Tsjakka/WeatherStation/Hardware/WeatherStation-top.png

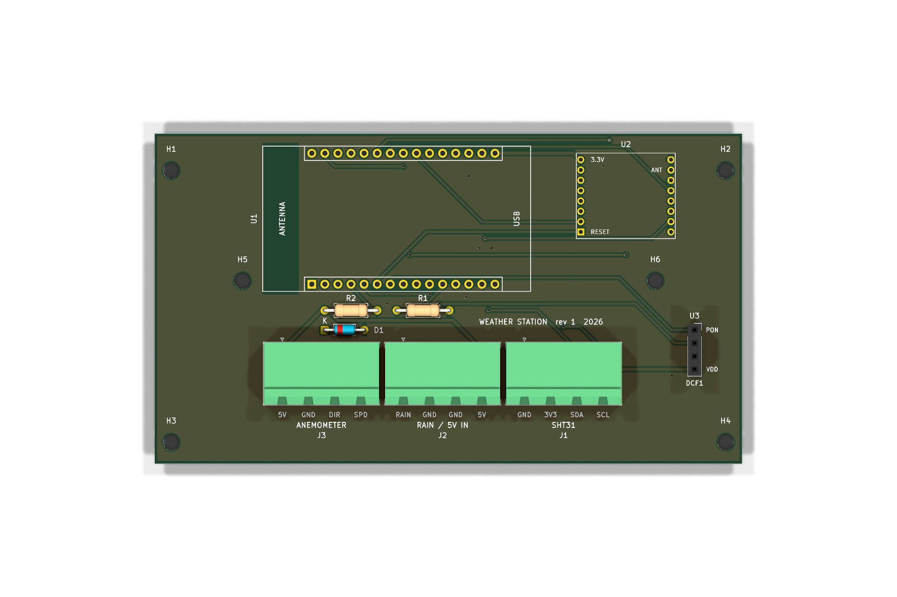
Hardware/WeatherStation-top.png
