Tsjakka/WeatherStation/Photos/Arduino settings.gif

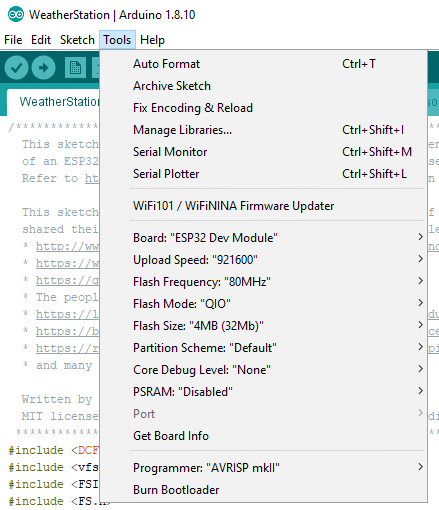
Photos/Arduino settings.gif
