Tsjakka/WeatherStation/Photos/IMG_2616.JPG

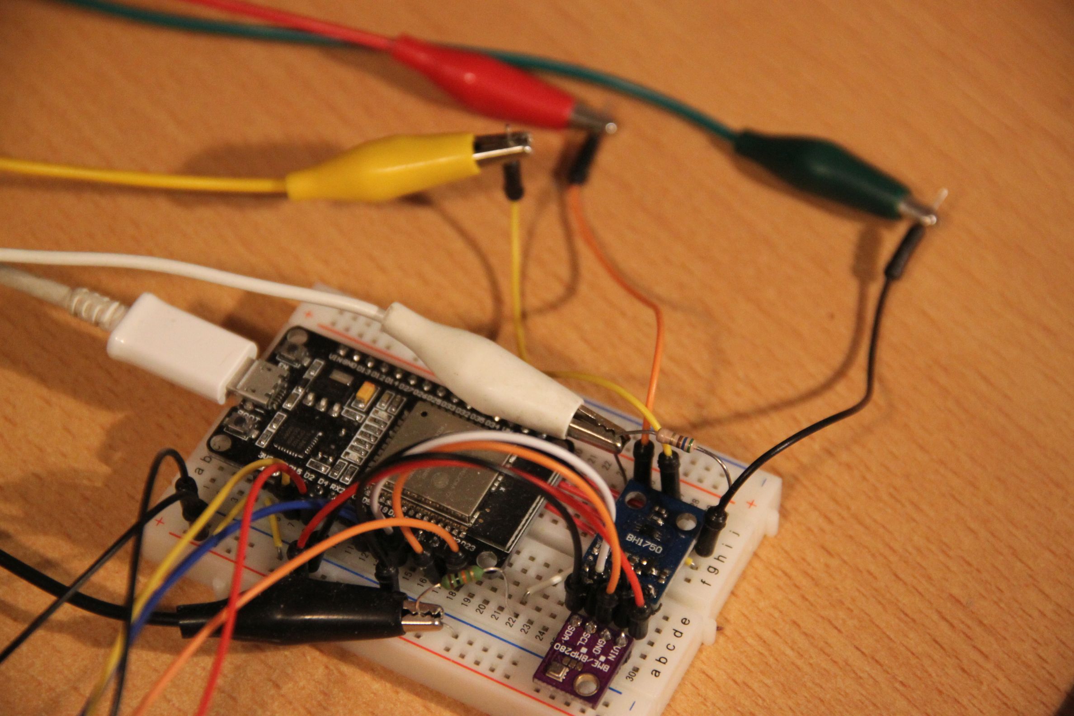
Photos/IMG_2616.JPG
