Tsjakka/WeatherStation/Photos/IMG_2619.JPG

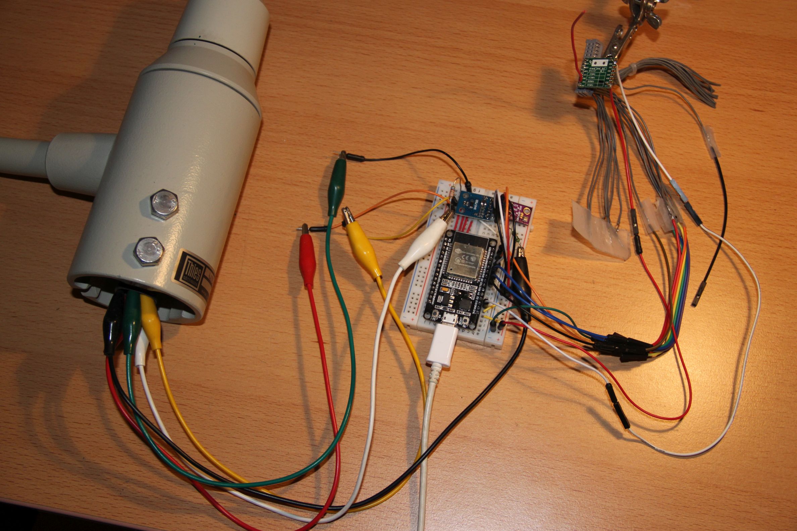
Photos/IMG_2619.JPG
