Tsjakka/WeatherStation/Photos/IMG_2621.JPG

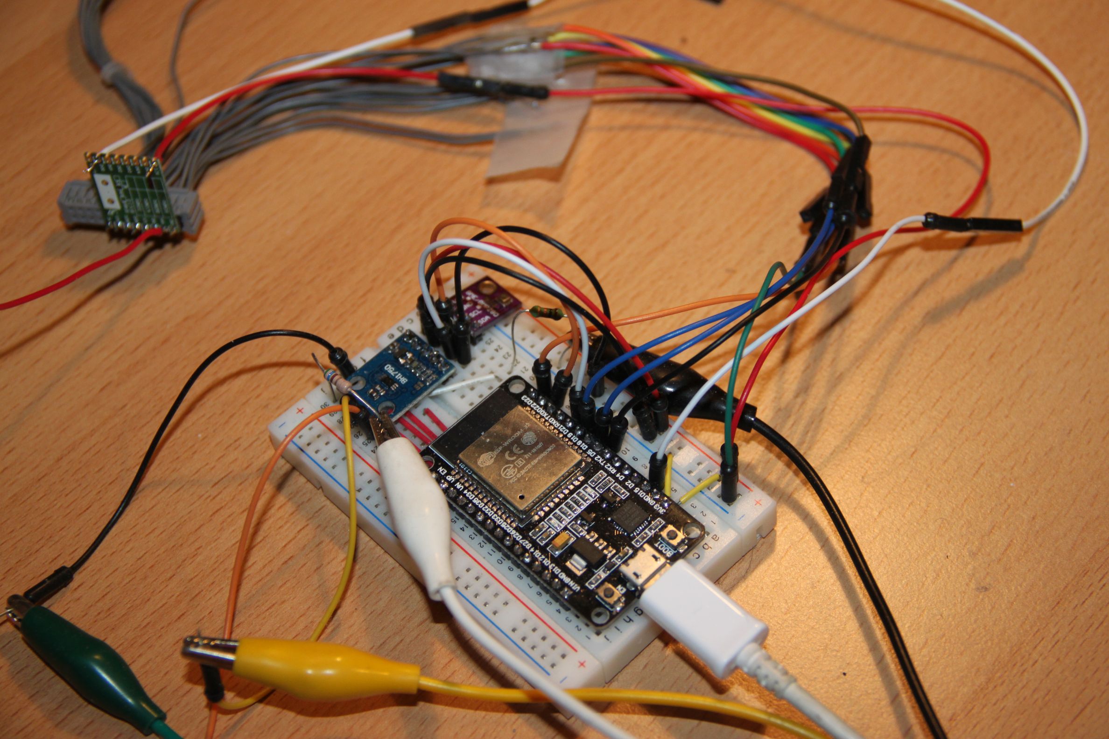
Photos/IMG_2621.JPG
