Tsjakka/WeatherStation/Photos/IMG_2628.JPG

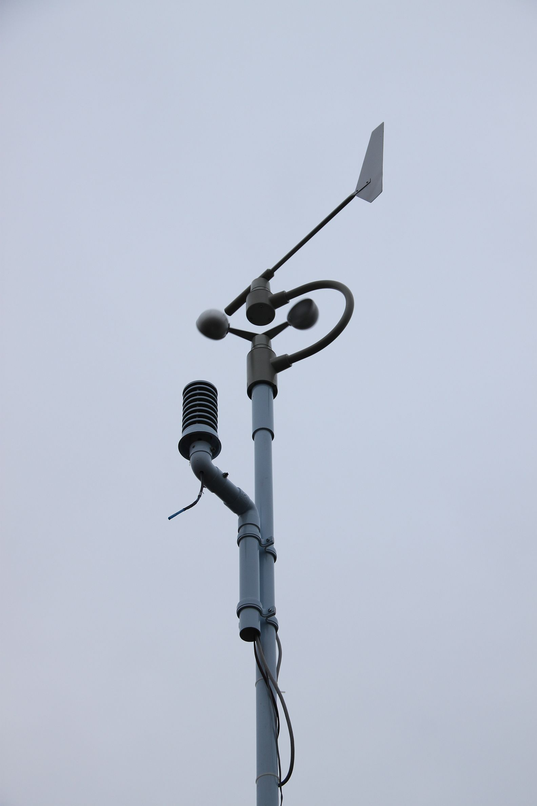
Photos/IMG_2628.JPG
