Tsjakka/WeatherStation/Photos/IMG_20181224_183357316.jpg

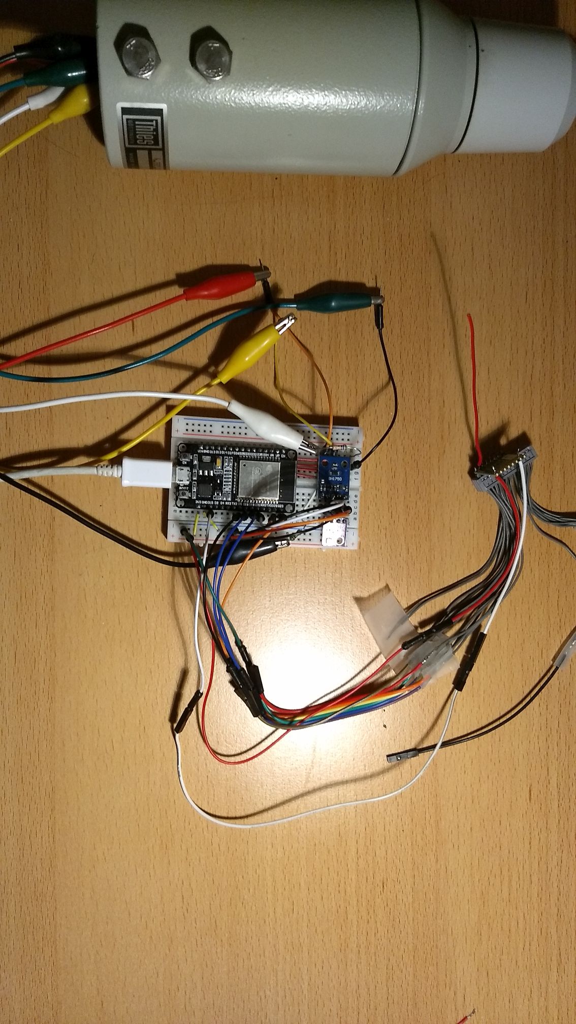
Photos/IMG_20181224_183357316.jpg
