Tsjakka/WeatherStation/Photos/IMG_20181224_183402917.jpg

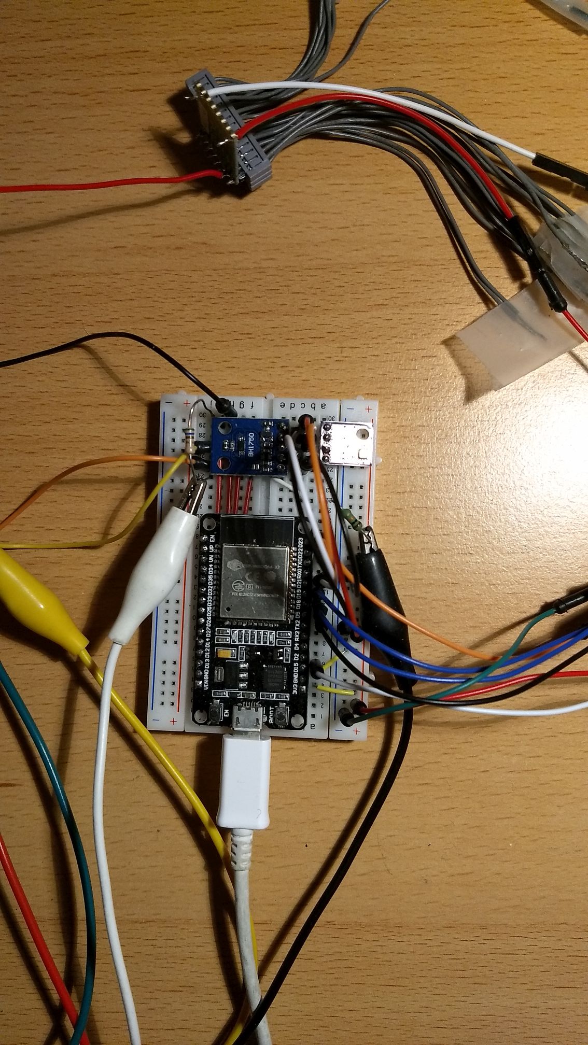
Photos/IMG_20181224_183402917.jpg
