Tsjakka/WeatherStation/Photos/IMG_20181224_183424407.jpg

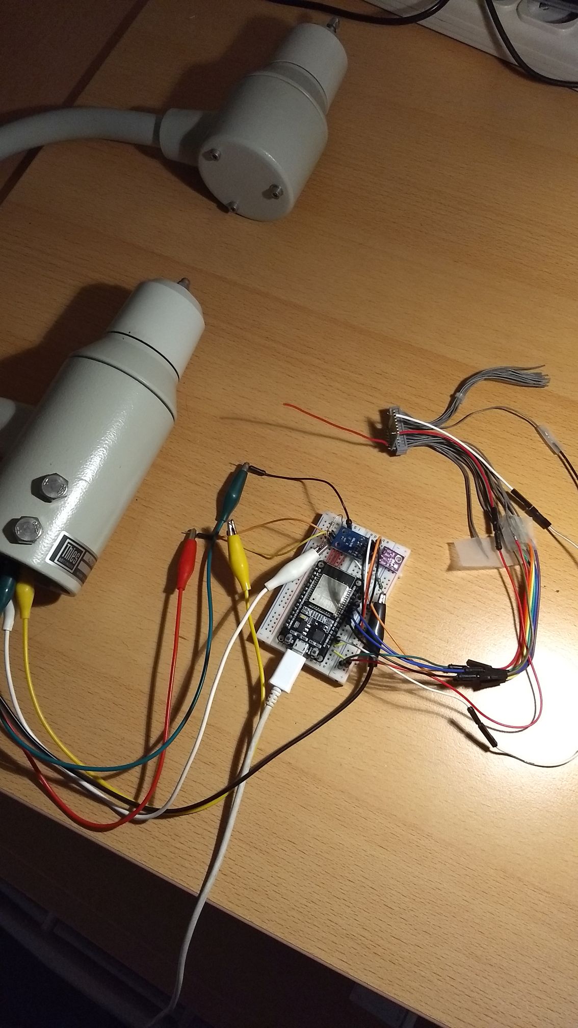
Photos/IMG_20181224_183424407.jpg
