Tsjakka/WeatherStation/Photos/IMG_20181224_183455740.jpg

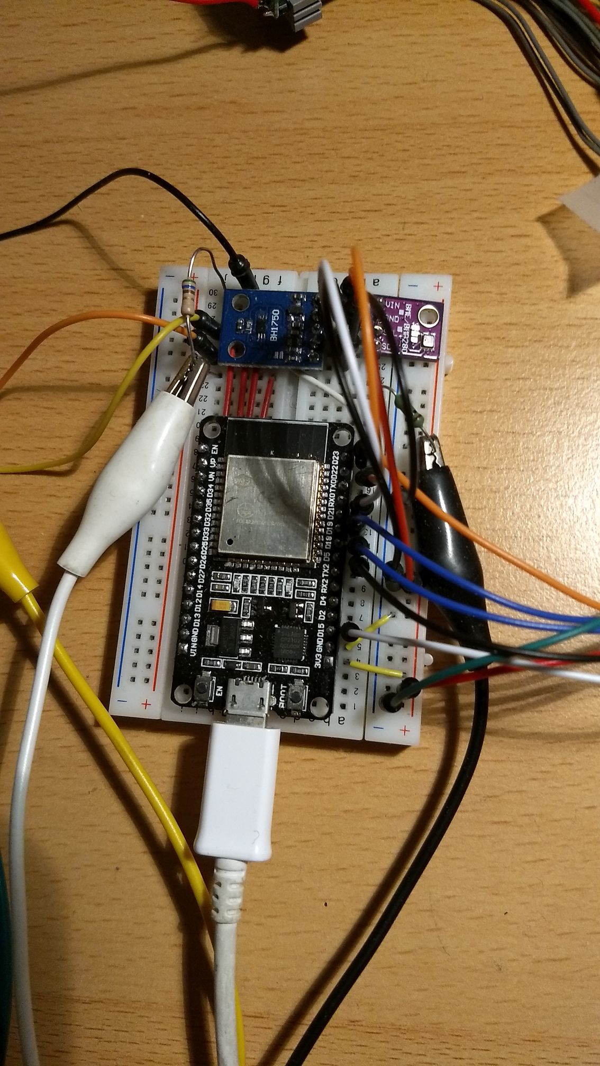
Photos/IMG_20181224_183455740.jpg
