Tsjakka/WeatherStation/Photos/IMG_20190520_220154558.jpg

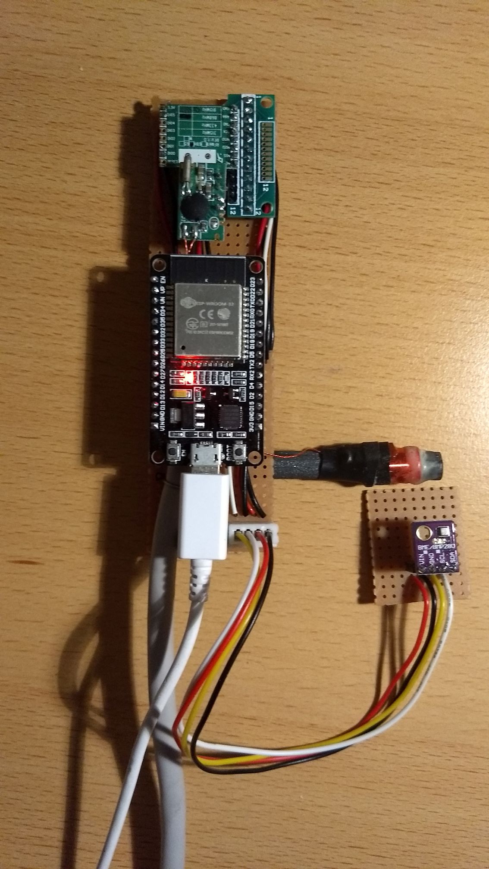
Photos/IMG_20190520_220154558.jpg
