Tsjakka/WeatherStation/Photos/IMG_20190521_210232744.jpg

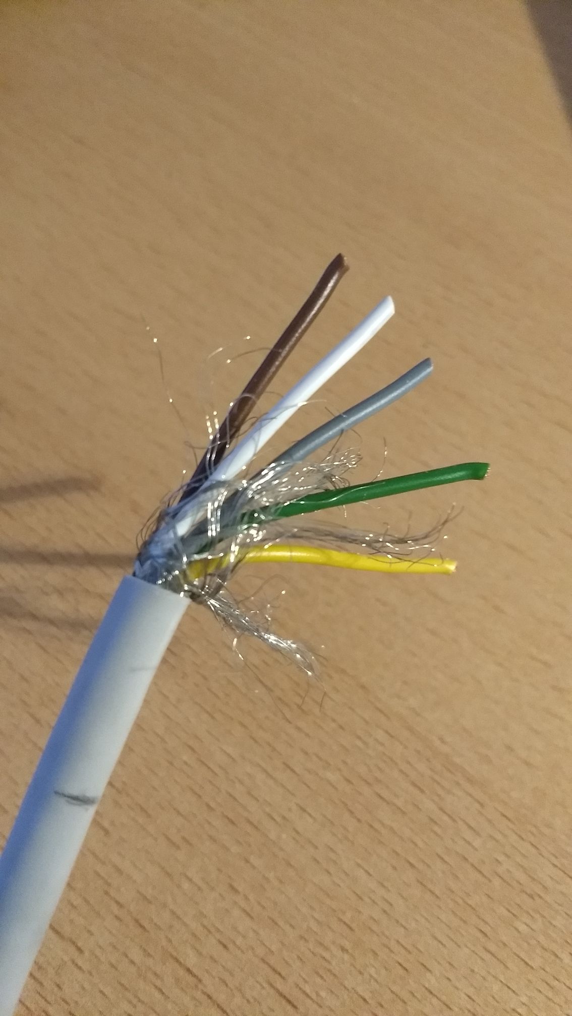
Photos/IMG_20190521_210232744.jpg
