Tsjakka/WeatherStation/Photos/IMG_20190720_095702261.jpg

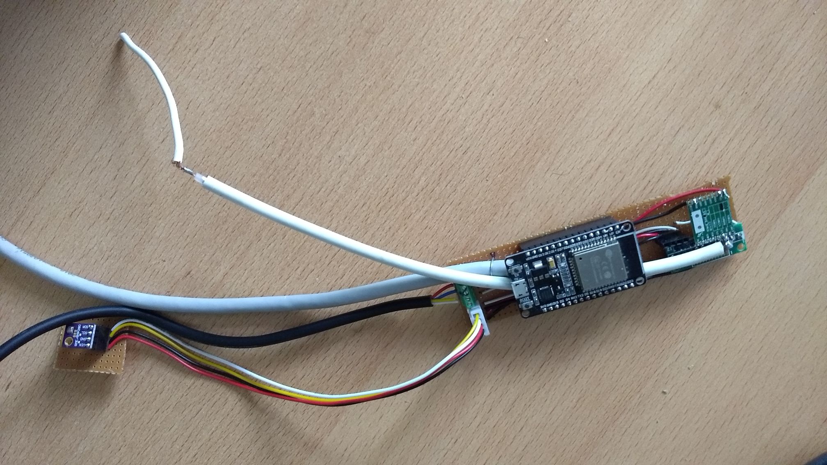
Photos/IMG_20190720_095702261.jpg
