Tsjakka/WeatherStation/Photos/IMG_20190720_095718628.jpg

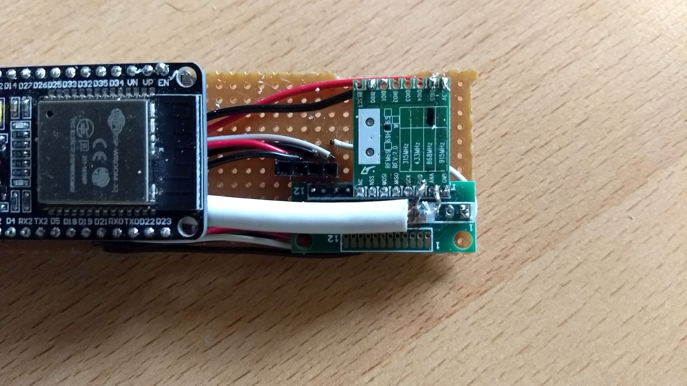
Photos/IMG_20190720_095718628.jpg
