Tsjakka/WeatherStation/Photos/IMG_20190803_145220831.jpg

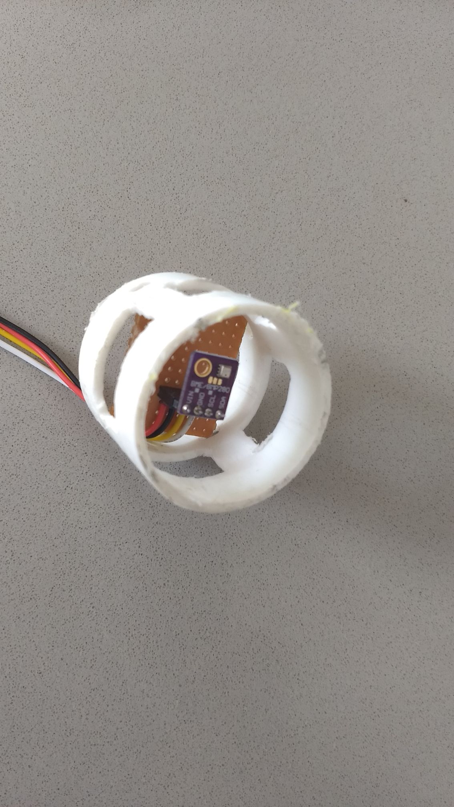
Photos/IMG_20190803_145220831.jpg
