Tsjakka/WeatherStation/Photos/IMG_20190803_145339822.jpg

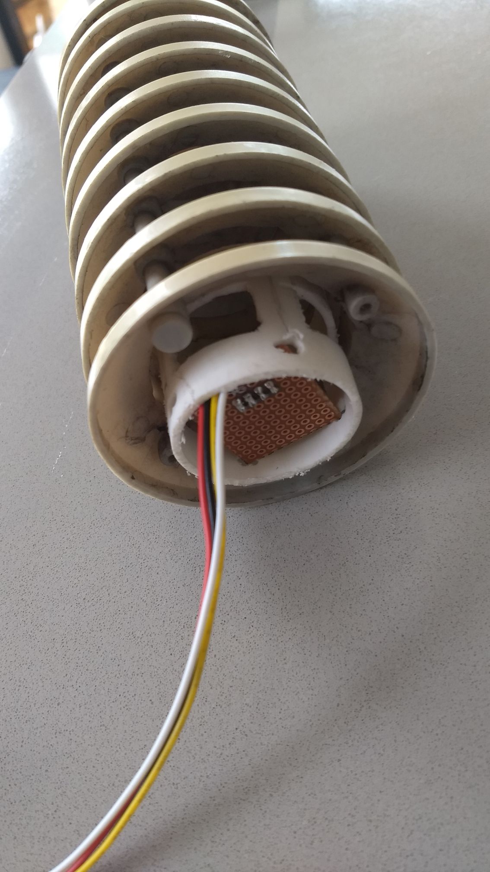
Photos/IMG_20190803_145339822.jpg
