Tsjakka/WeatherStation/Photos/IMG_20190807_215347973.jpg

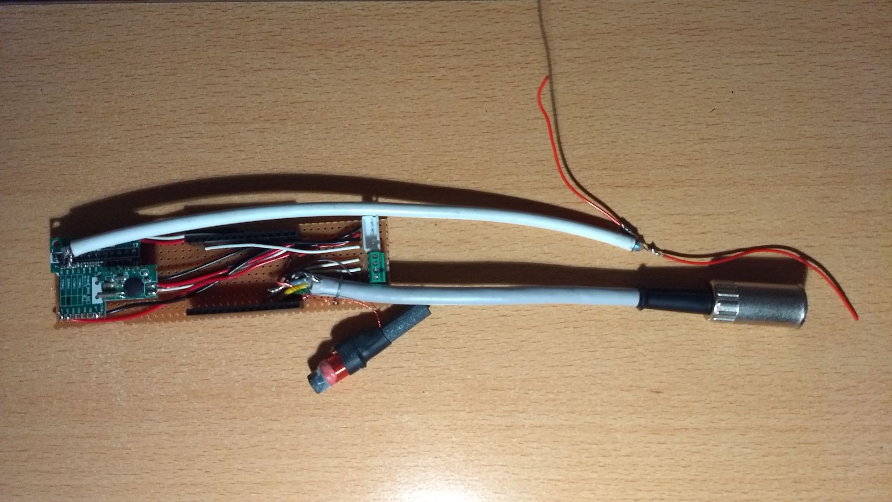
Photos/IMG_20190807_215347973.jpg
