Tsjakka/WeatherStation/Photos/IMG_20190807_215413689.jpg

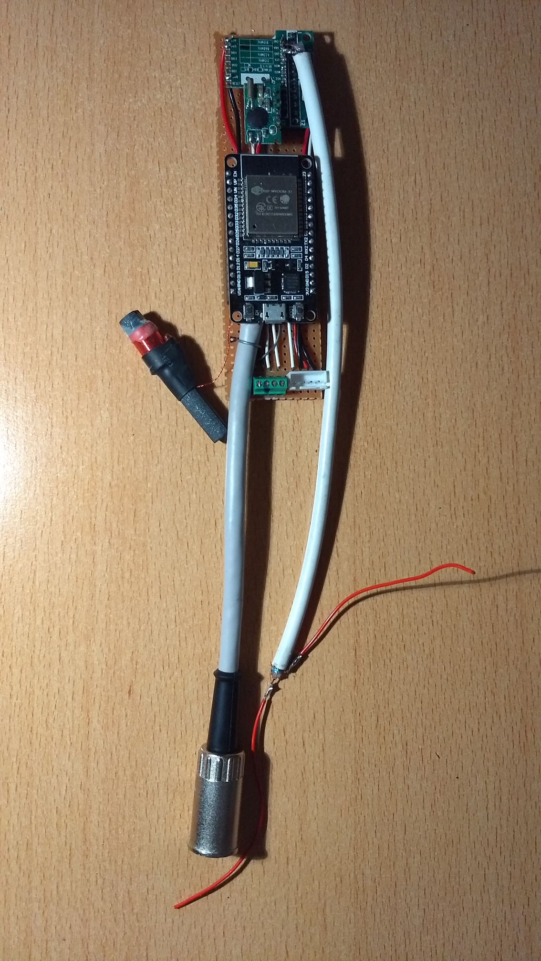
Photos/IMG_20190807_215413689.jpg
