Tsjakka/WeatherStation/Photos/IMG_20190807_215417791_small.jpg

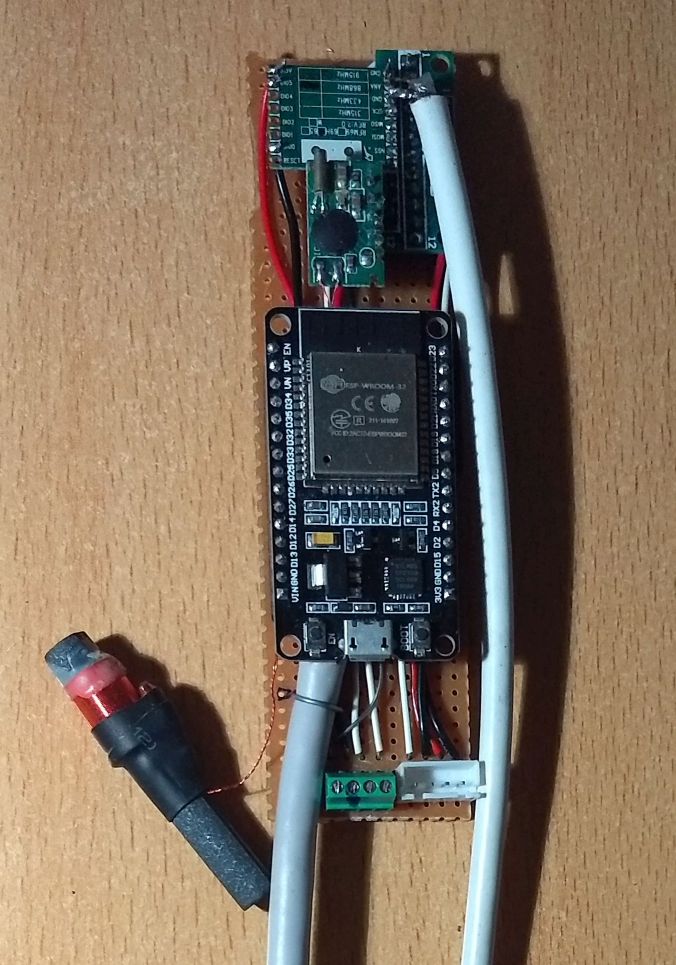
Photos/IMG_20190807_215417791_small.jpg
