Tsjakka/WeatherStation/Photos/IMG_20190813_203214440_HDR.jpg

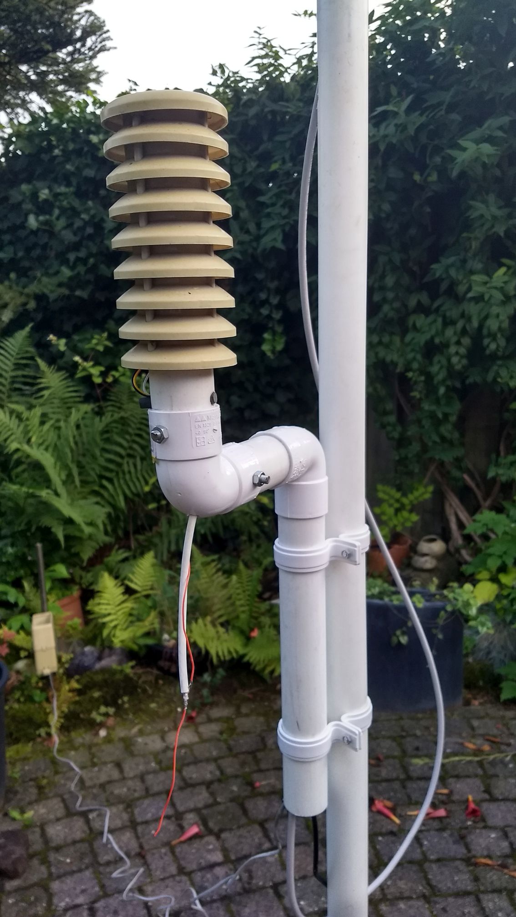
Photos/IMG_20190813_203214440_HDR.jpg
