Tsjakka/WeatherStation/Photos/PB140029.JPG

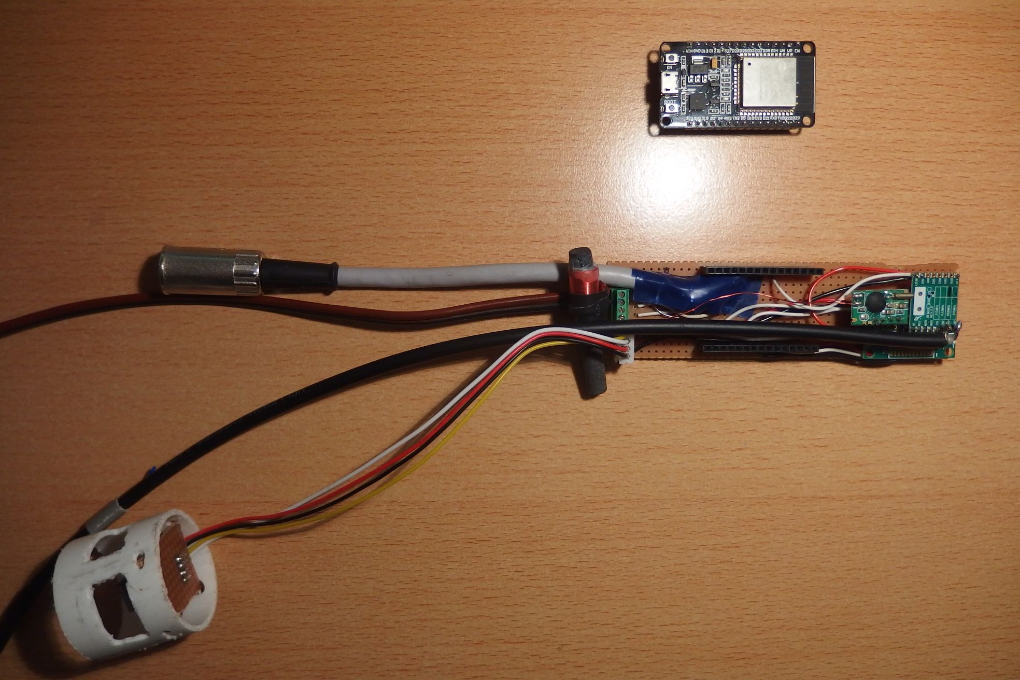
Photos/PB140029.JPG
