Tsjakka/WeatherStation/Photos/PB140033.JPG

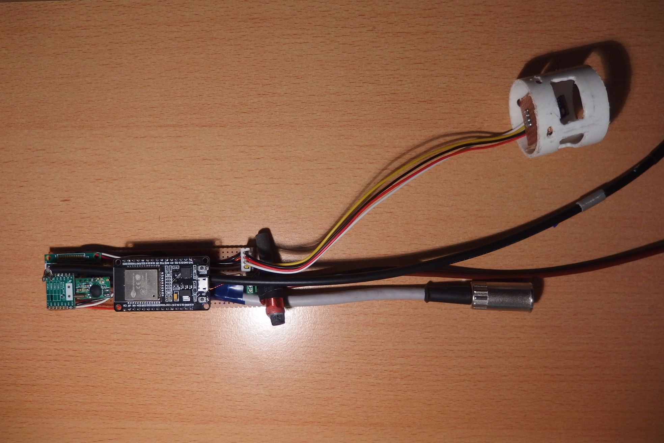
Photos/PB140033.JPG
