Tsjakka/WeatherStation/Photos/PB140034.JPG

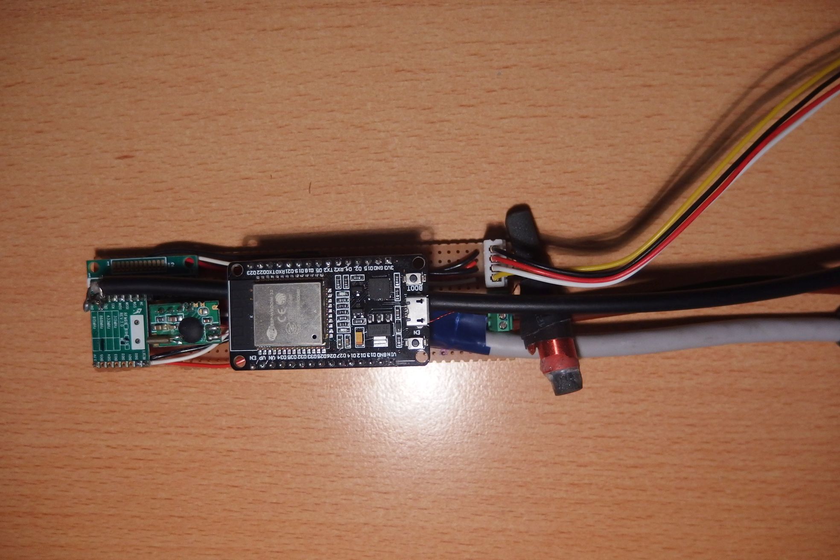
Photos/PB140034.JPG
