Tsjakka/WeatherStation/Photos/PB140035.JPG

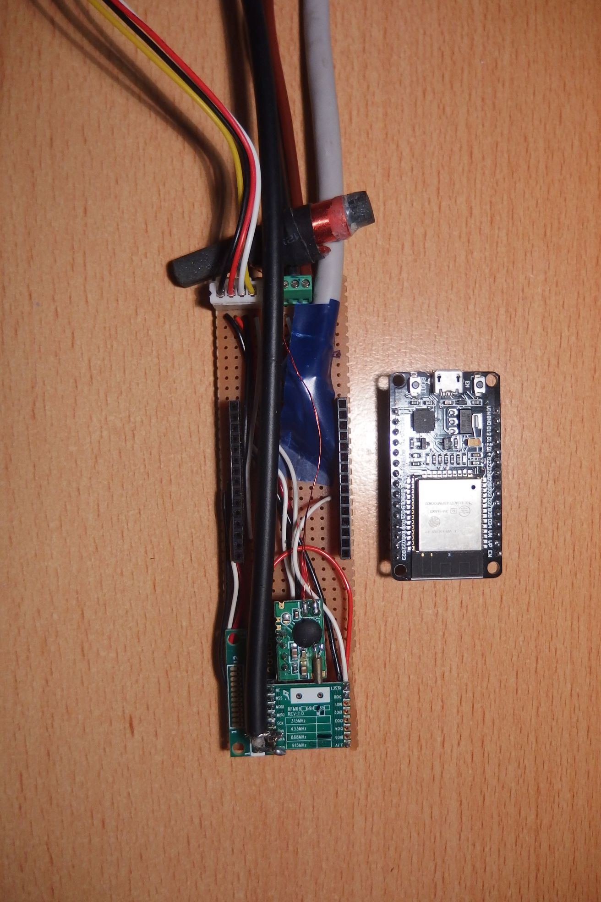
Photos/PB140035.JPG
