Tsjakka/WeatherStation/Photos/PB140037.JPG

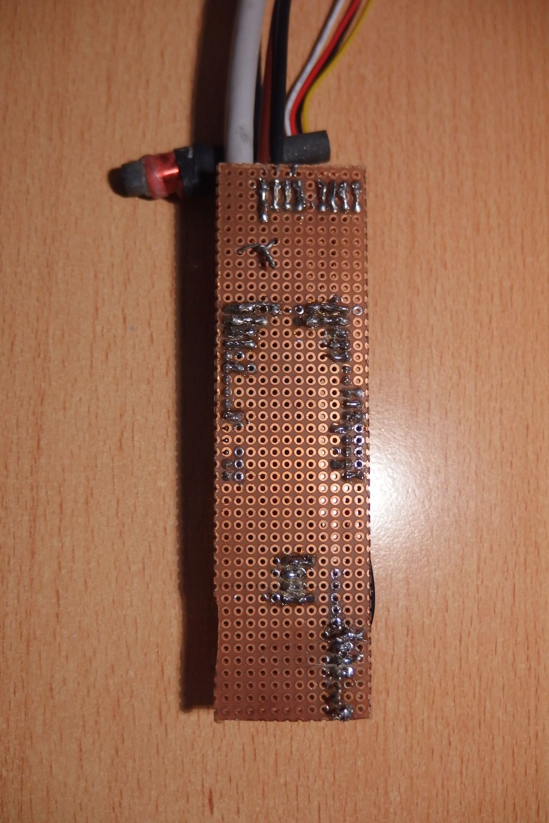
Photos/PB140037.JPG
