Tsjakka/WeatherStation/Photos/PB140038.JPG

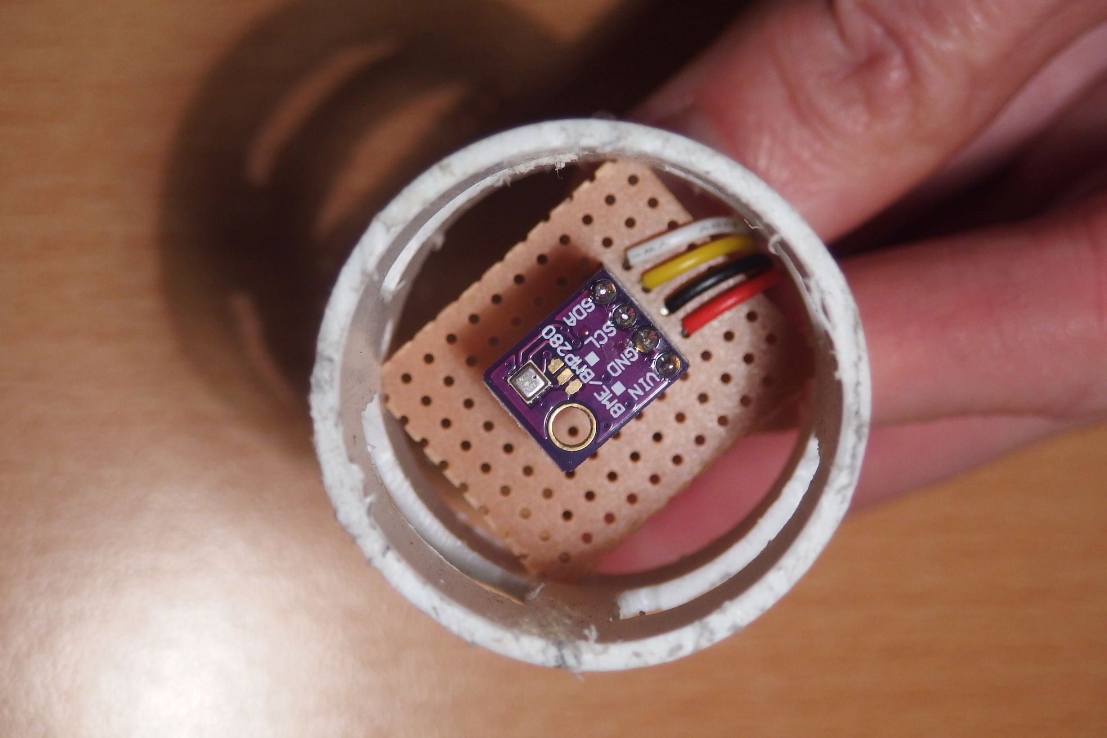
Photos/PB140038.JPG
