Tsjakka/WeatherStation/Photos/PB160040.JPG

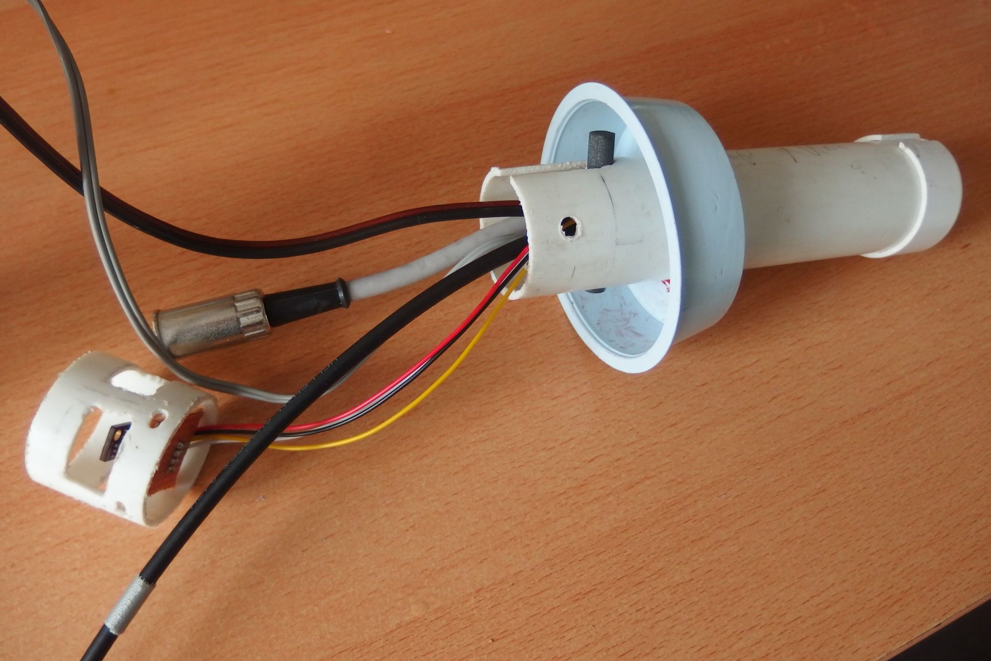
Photos/PB160040.JPG
