Tsjakka/WeatherStation/Photos/PB160041.JPG

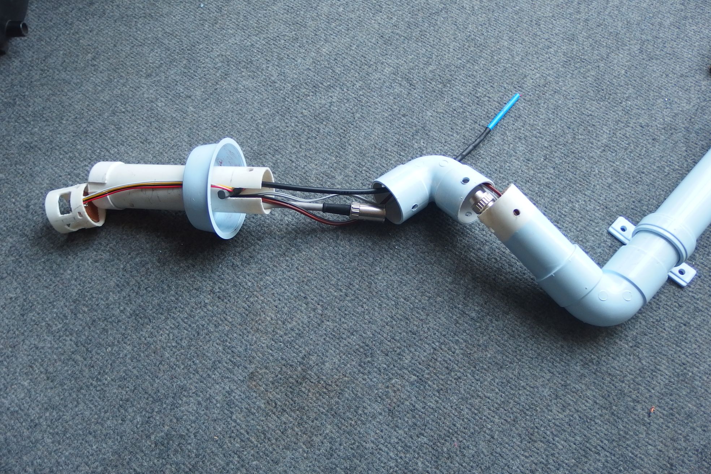
Photos/PB160041.JPG
