Tsjakka/WeatherStation/Photos/PB160042.JPG

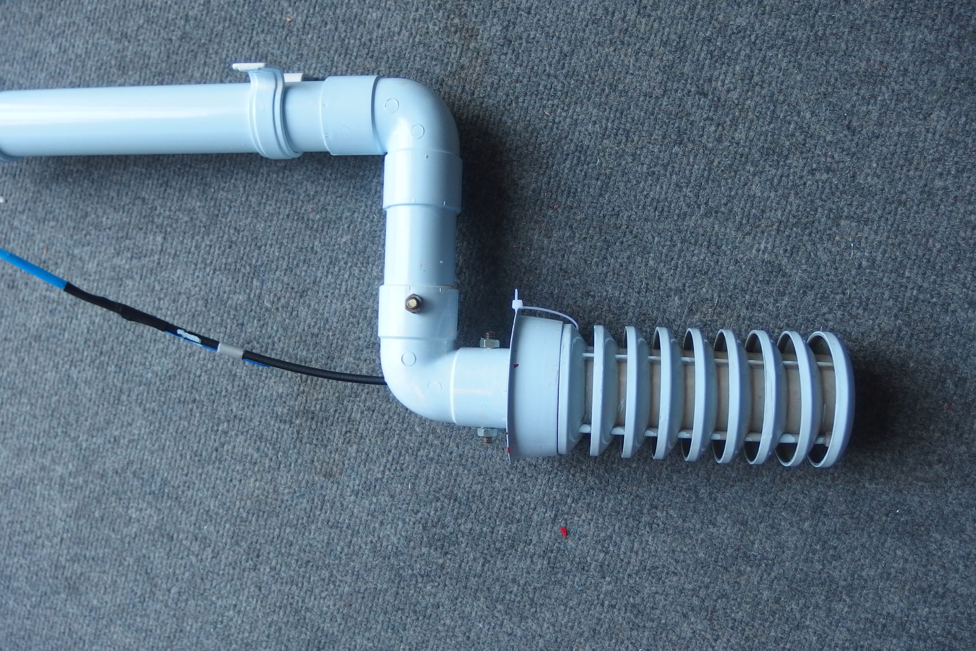
Photos/PB160042.JPG
