Tsjakka/WeatherStation/Photos/PB160043.JPG

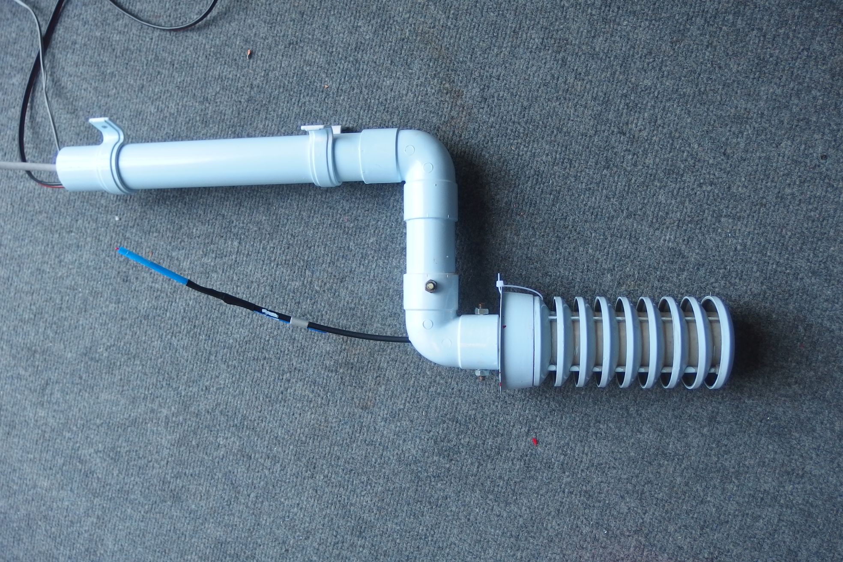
Photos/PB160043.JPG
