Tsjakka/WeatherStation/Photos/Schematic.jpg

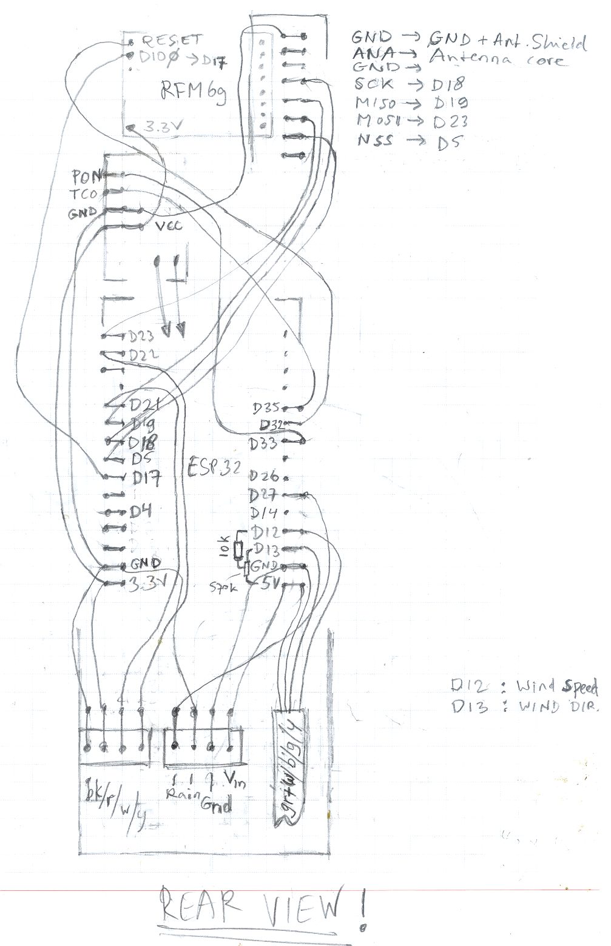
Photos/Schematic.jpg
