Tsjakka/WeatherStation/(threads)

Thread 1 (2023-03-23):

Which DCF77 library?

zoomx, 2023-03-23:
Wich DCF77 library was used?
The one written by udoklein support AVR and STM32F1 architecture but not ESP32, it gives
```
exit status 1
#error Unsupported controller architecture
```

Tsjakka, 2023-03-23:
That would be DCF77 by Thijs Elenbaas v1.0.0.

zoomx, 2023-03-23:
So this one
[](https://github.com/thijse/Arduino-DCF77/releases/tag/1.0.0)
Thanks

Closed 2023-03-23.
