Tsjakka/WeatherStation/Hardware/WeatherStation.pdf

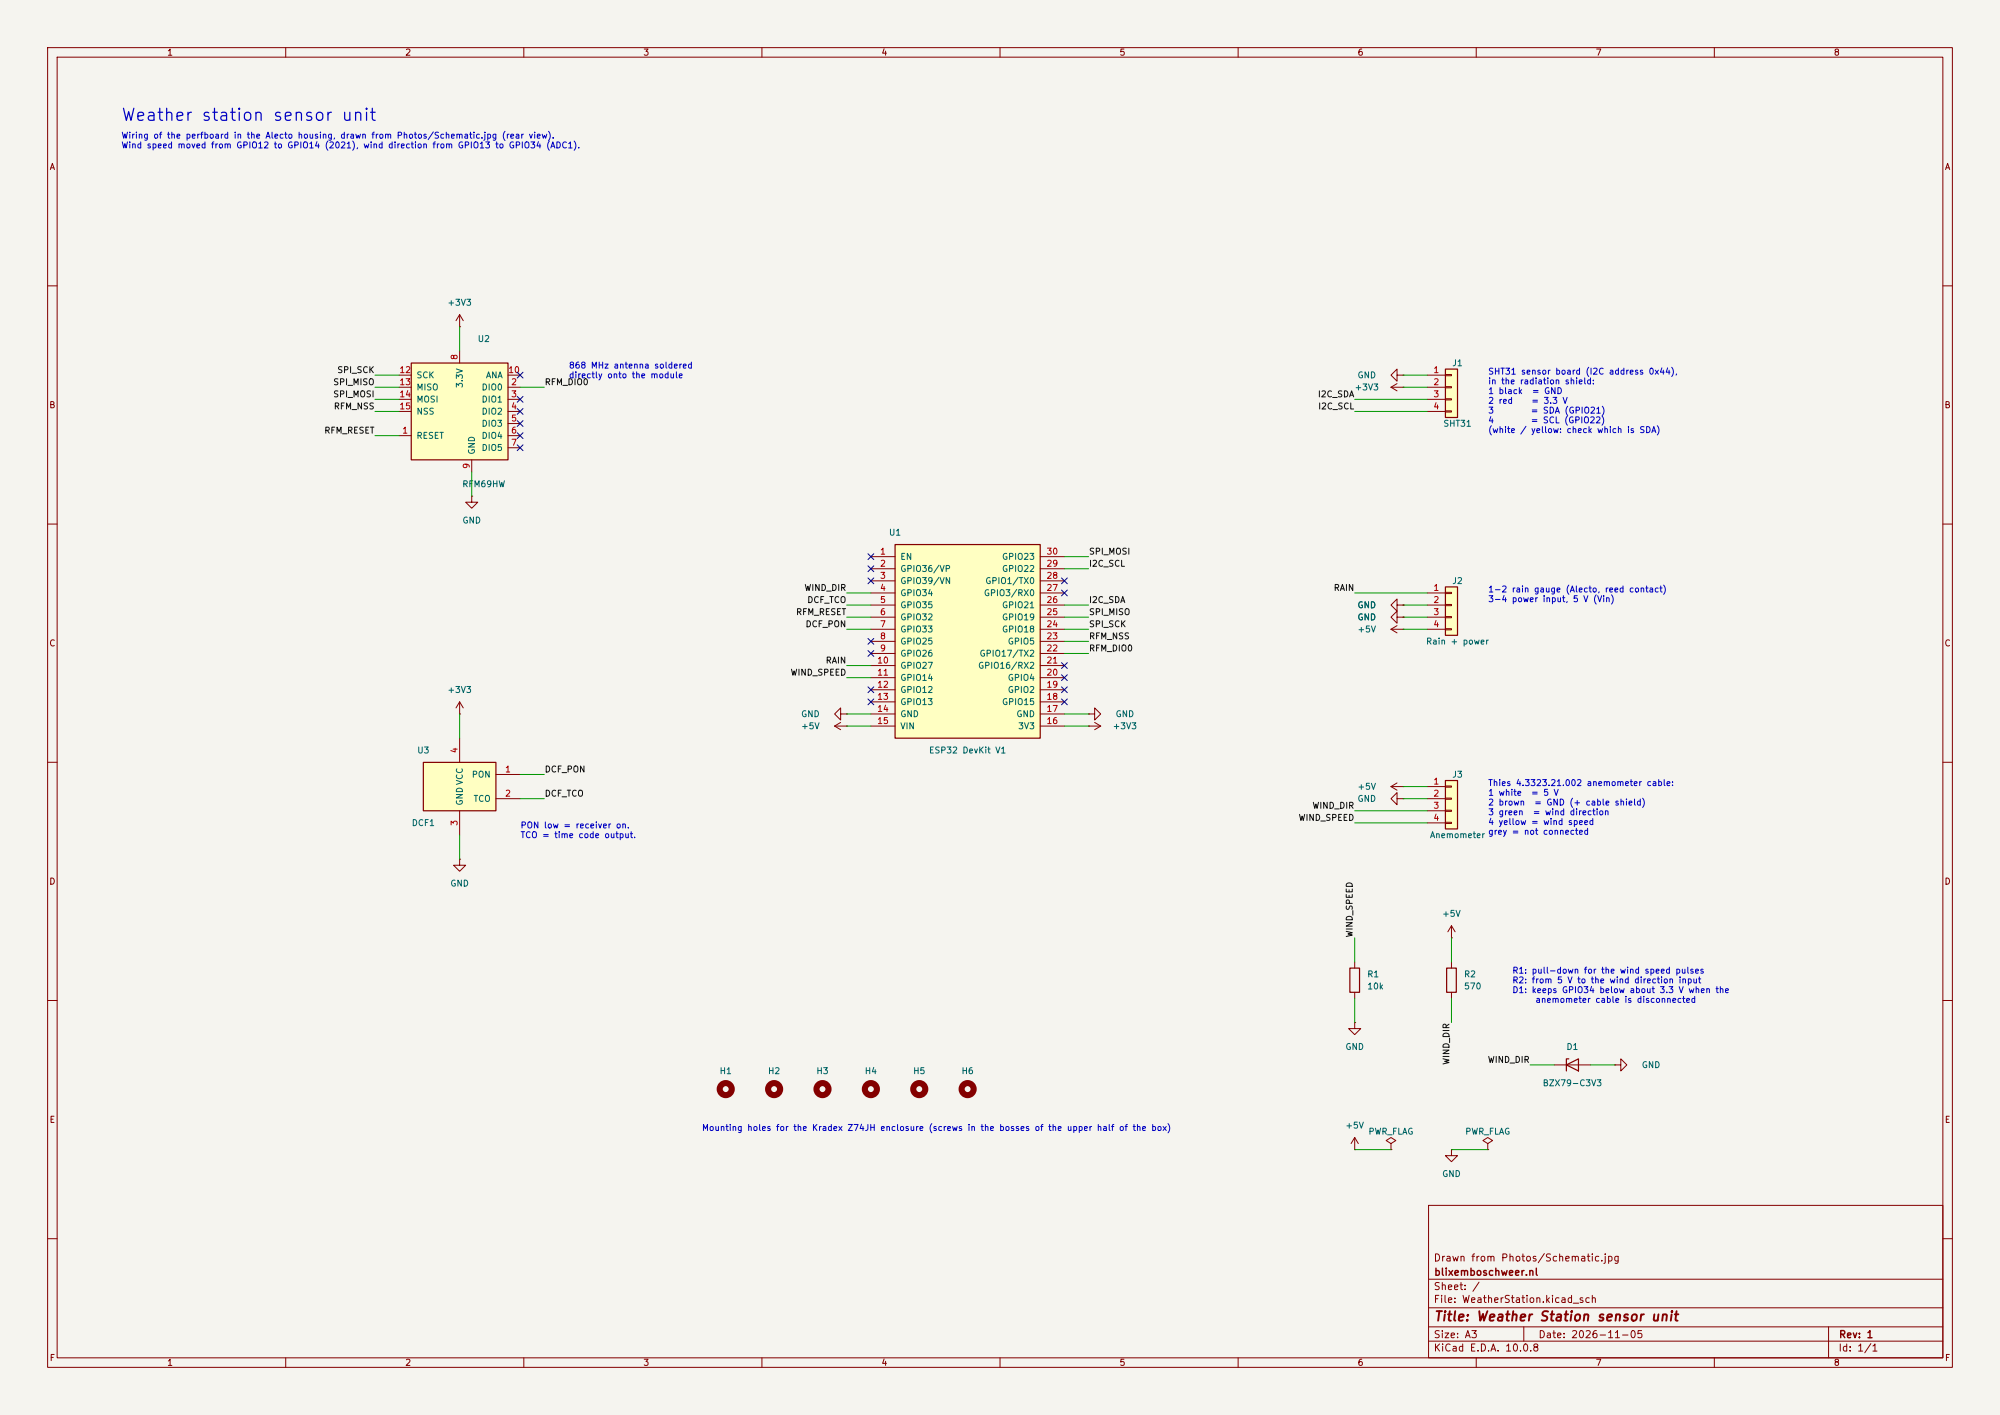
[picture p36: page 1]

Weather station sensor unit

Wiring of the perfboard in the Alecto housing, drawn from Photos/Schematic.jpg (rear view). Wind speed moved from GPIO12 to GPIO14 (2021), wind direction from GPIO13 to GPIO34 (ADC1). 868 MHz antenna soldered

SHT31 sensor board (I2C address 0x44),
in the radiation shield: 1 black = GND

(white / yellow: check which is SDA)

grey = not connected 1-2 rain gauge (Alecto, reed contact) 3-4 power input, 5 V (Vin)

Thies 4.3323.21.002 anemometer cable: 1 white = 5 V 2 brown = GND (+ cable shield) 3 green = wind direction 4 yellow = wind speed

Mounting holes for the Kradex Z74JH enclosure (screws in the bosses of the upper half of the box)

Drawn from Photos/Schematic.jpg
blixemboschweer.nl
Sheet: /
File: WeatherStation.kicad_sch
Title: Weather Station sensor unit

Size: A3 | Rev: 1 | F Date: 2026-11-05
KiCad E.D.A. 10.0.8 | Id: 1/1
