Tsjakka/WeatherStation/Hardware/WeatherStation.kicad_pcb

## KiCad design Hardware/WeatherStation.kicad_pcb (2026-11-06)

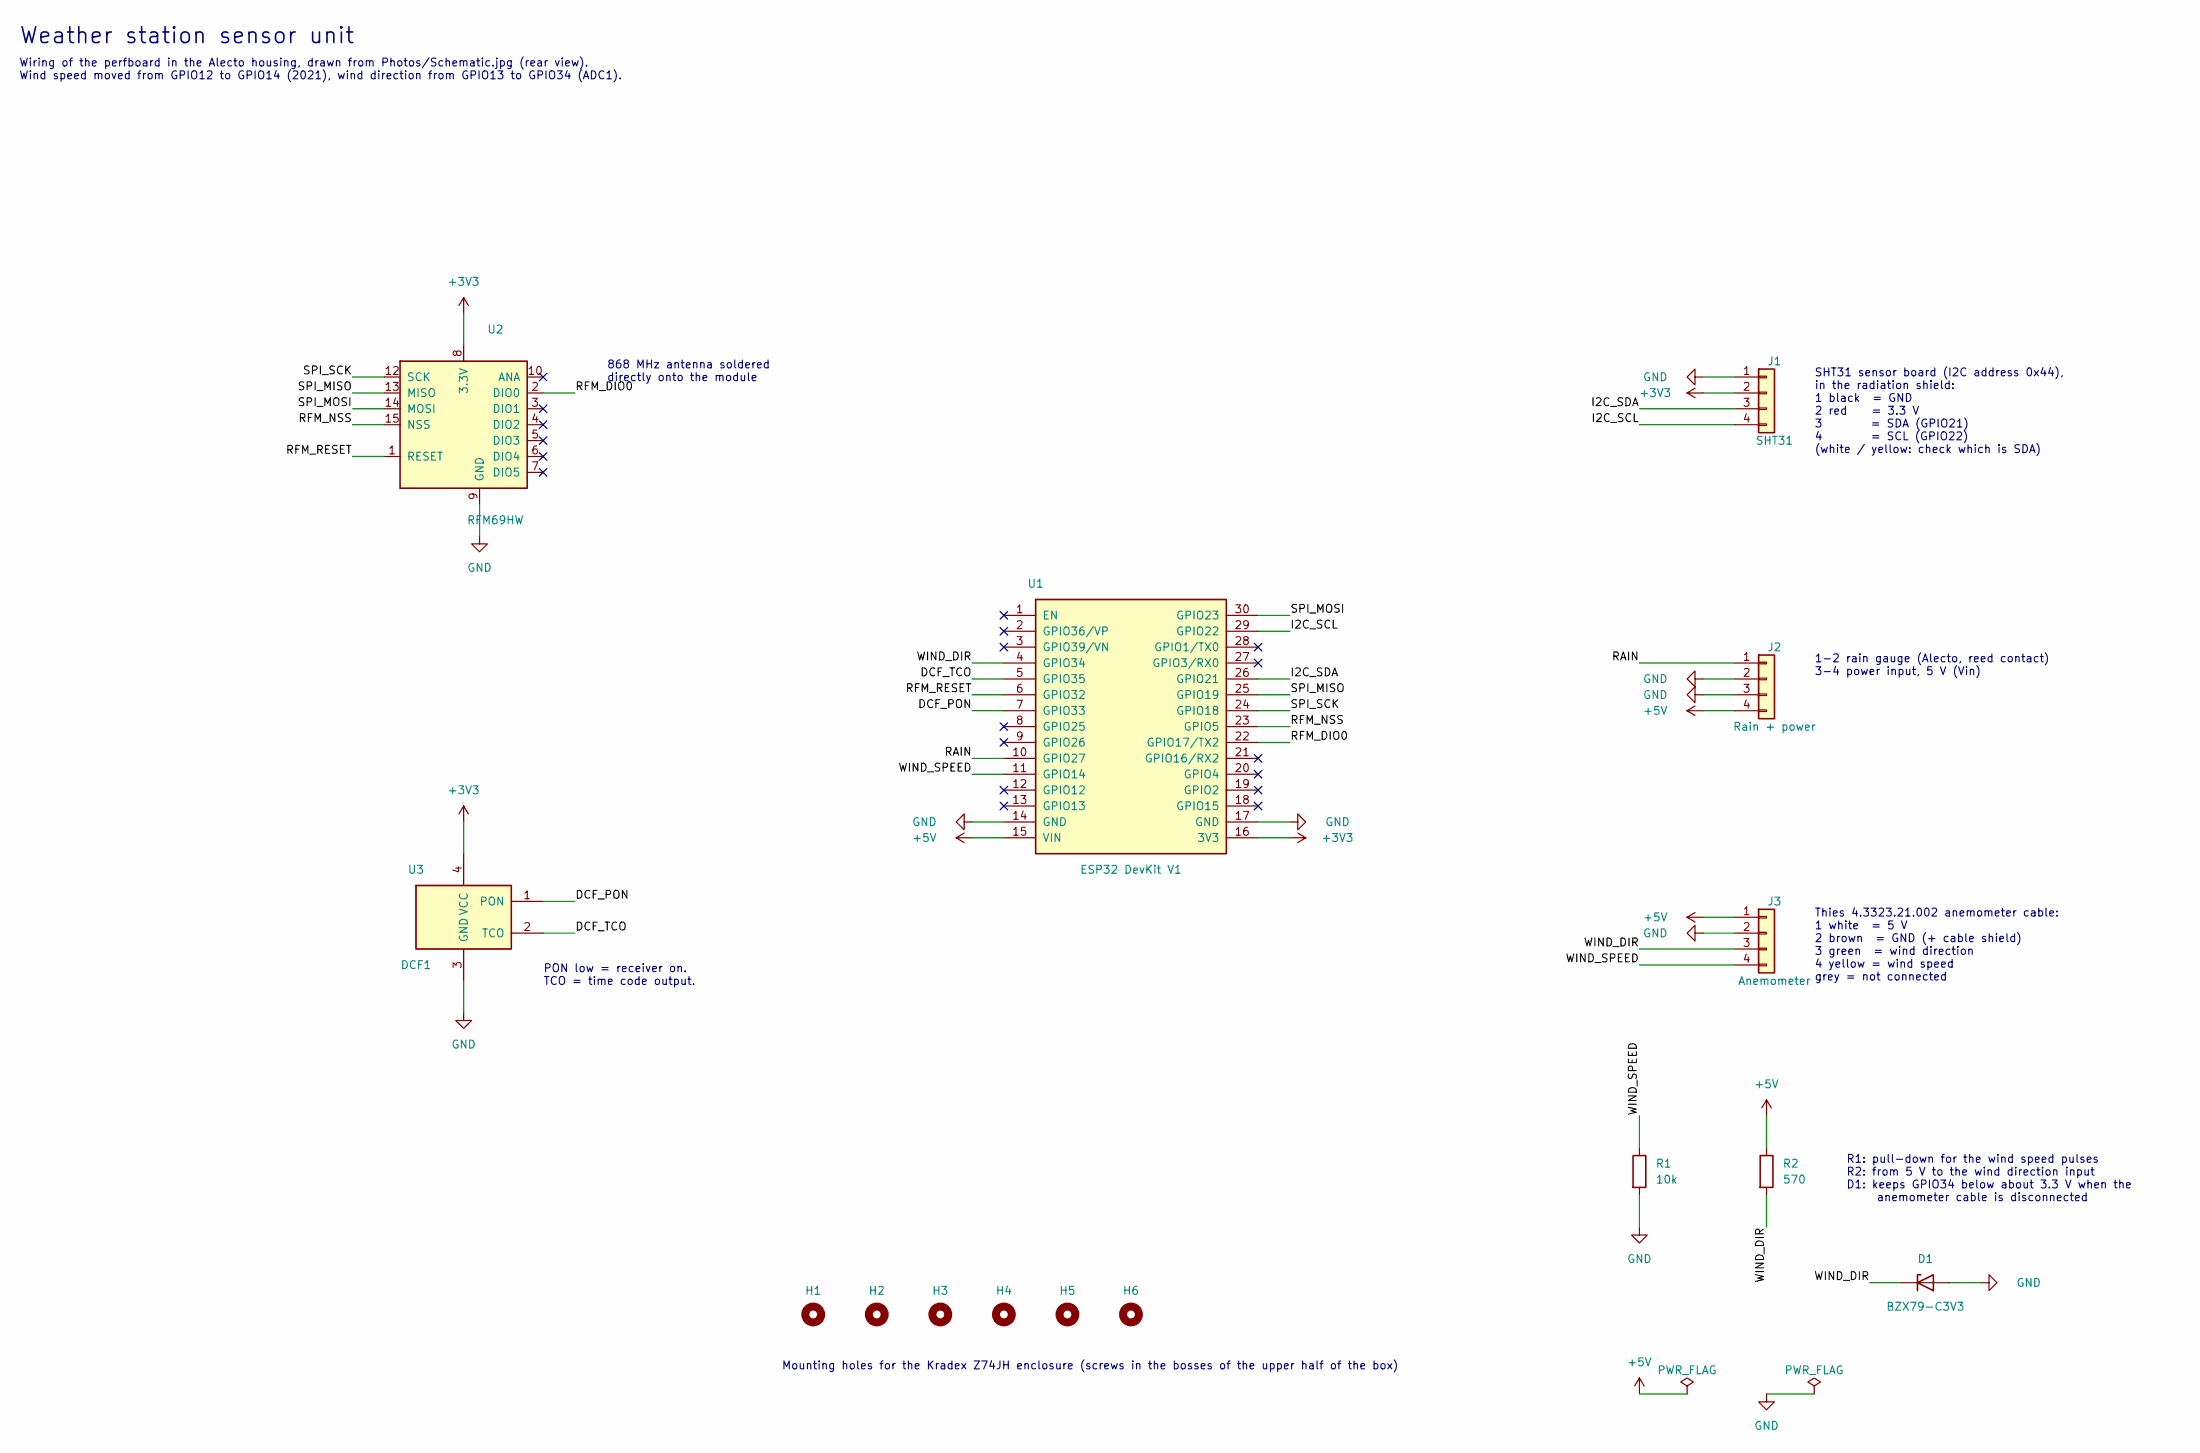
[picture p37: schematic WeatherStation.kicad_sch, Weather Station sensor unit]

Parts:
D1: BZX79-C3V3; D_DO-35_SOD27_P7.62mm_Horizontal
H1, H2, H3, H4, H5, H6: MountingHole; MountingHole_3.2mm_M3
J1: SHT31; PhoenixContact_MSTBA_2,5_4-G-5,08_1x04_P5.08mm_Horizontal
J2: Rain + power; PhoenixContact_MSTBA_2,5_4-G-5,08_1x04_P5.08mm_Horizontal
J3: Anemometer; PhoenixContact_MSTBA_2,5_4-G-5,08_1x04_P5.08mm_Horizontal
R1: 10k; R_Axial_DIN0207_L6.3mm_D2.5mm_P10.16mm_Horizontal
R2: 570; R_Axial_DIN0207_L6.3mm_D2.5mm_P10.16mm_Horizontal
U1: ESP32 DevKit V1; ESP32_DevKit_30_Socket
U2: RFM69HW; RFM69HW_Socket_2.00mm
U3: DCF1; PinSocket_1x04_P2.54mm_Vertical

Connections:
+3V3: J1.2, U1.16 (3V3), U2.8 (3.3V), U3.4 (VCC)
+5V: J2.4, J3.1, R2.1, U1.15 (VIN)
/DCF_PON: U1.7 (GPIO33), U3.1 (PON)
/DCF_TCO: U1.5 (GPIO35), U3.2 (TCO)
/I2C_SCL: J1.4, U1.29 (GPIO22)
/I2C_SDA: J1.3, U1.26 (GPIO21)
/RAIN: J2.1, U1.10 (GPIO27)
/RFM_DIO0: U1.22 (GPIO17/TX2), U2.2 (DIO0)
/RFM_NSS: U1.23 (GPIO5), U2.15 (NSS)
/RFM_RESET: U1.6 (GPIO32), U2.1 (RESET)
/SPI_MISO: U1.25 (GPIO19), U2.13 (MISO)
/SPI_MOSI: U1.30 (GPIO23), U2.14 (MOSI)
/SPI_SCK: U1.24 (GPIO18), U2.12 (SCK)
/WIND_DIR: D1.1 (K), J3.3, R2.2, U1.4 (GPIO34)
/WIND_SPEED: J3.4, R1.1, U1.11 (GPIO14)
GND: D1.2 (A), J1.1, J2.2, J2.3, J3.2, R1.2, U1.14 (GND), U1.17 (GND), U2.9 (GND), U2.11 (GND), U3.3 (GND)

Notes on the sheet:
868 MHz antenna soldered directly onto the module
Weather station sensor unit
PON low = receiver on. TCO = time code output.
R1: pull-down for the wind speed pulses R2: from 5 V to the wind direction input D1: keeps GPIO34 below about 3.3 V when the anemometer cable is disconnected
1-2 rain gauge (Alecto, reed contact) 3-4 power input, 5 V (Vin)
SHT31 sensor board (I2C address 0x44), in the radiation shield: 1 black = GND 2 red = 3.3 V 3 = SDA (GPIO21) 4 = SCL (GPIO22) (white / yellow: check which is SDA)
Thies 4.3323.21.002 anemometer cable: 1 white = 5 V 2 brown = GND (+ cable shield) 3 green = wind direction 4 yellow = wind speed grey = not connected
Wiring of the perfboard in the Alecto housing, drawn from Photos/Schematic.jpg (rear view). Wind speed moved from GPIO12 to GPIO14 (2021), wind direction from GPIO13 to GPIO34 (ADC1).
Mounting holes for the Kradex Z74JH enclosure (screws in the bosses of the upper half of the box)

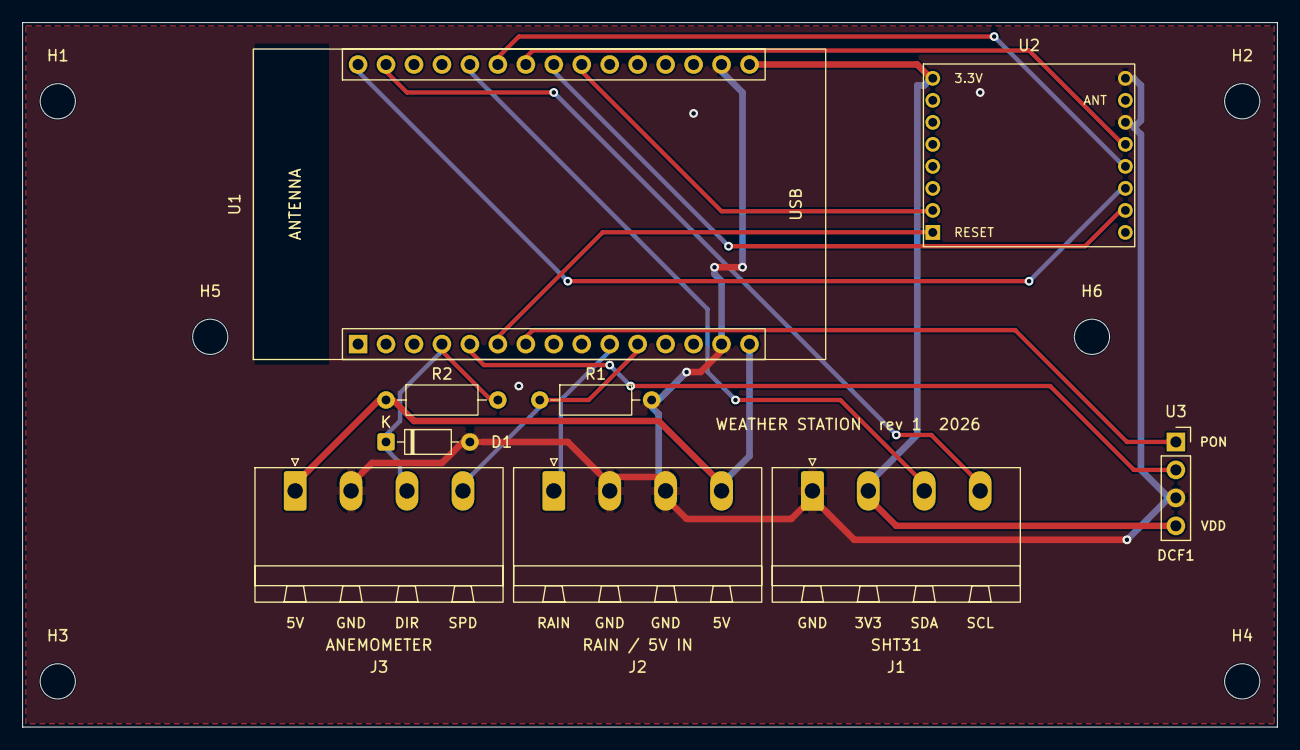
[picture p38: board WeatherStation.kicad_pcb from above]

Board: 2 copper layers, 114.0 x 64.0 mm, 15 parts (0 on the bottom side), 16 nets.
