Tsjakka/WeatherStation/WeatherStation/WeatherStation.ino

/***************************************************************************
  This sketch makes a Fine Offset WH1080 compatible remote sensor unit out
  of an ESP32, a professional Thies anemometer and an SHT31 sensor board.
  Refer to https://blixemboschweer.nl/ for more information on the used hardware.

  This sketch would not have been posible without the help of people who
  shared their code and knowledge on the internet. For example:
  * http://www.susa.net/wordpress/2012/08/raspberry-pi-reading-wh1081-weather-sensors-using-an-rfm01-and-rfm12b/
  * https://www.sevenwatt.com/main/wh1080-protocol-v2-fsk/
  * https://github.com/rinie/LaCrosseITPlusReader
  * The people at Adafruit for their SHT31 library.
  * https://lastminuteengineers.com/esp32-ota-web-updater-arduino-ide/
  * https://blog.blinkenlight.net/experiments/dcf77/dcf77-receiver-modules/
  * https://randomnerdtutorials.com/esp32-pinout-reference-gpios/
  * https://learn.sparkfun.com/tutorials/rfm69hcw-hookup-guide
  * and many others.

  Written by Tsjakka from The Netherlands.
  MIT license, this comment block must be included in any redistribution.
 ***************************************************************************/
#include <Time.h>
#include <TimeLib.h>
#include <DCF77.h>
#include <Preferences.h>
#include <WiFi.h>
#include <WebServer.h>
#include <Update.h>
#include <Adafruit_Sensor.h>
#include <Adafruit_SHT31.h>
//#include <BH1750.h>
#include "WH1080.h"
#include "Thies.h"
#include "Secrets.h"    // Wifi credentials, see below. This file is not stored in git.

Preferences preferences;
WebServer server(80);
WH1080 wh1080;          // The class that takes care of communicating with the base station.
Thies thies;            // The class that collects information from the Thies anemometer.
Adafruit_SHT31 sht = Adafruit_SHT31();    // The class that controls the SHT31 sensor.
//BH1750 lightMeter;      // The class that controls the BH1750 sensor. Disabled (the WH1080 does not support this).
WH1080::WeatherData weatherData;    // Data structure for passing weather data to WH1080 class.

// ************************************************************************
// Create file Secrets.h with the following contents. Replace with your
// information where indicated.
// ************************************************************************
/*
// Wifi connection
const char* host      = "WeatherStation";               // Host name used for Preferences and DNS
const char* ssid      = "REPLACE_WITH_YOUR_SSID";       // Network name
const char* password  = "REPLACE_WITH_YOUR_PASSWORD";   // Network password

// Optional: user name and password for the OTA update page (default admin / submit)
//#define OTA_USER      "REPLACE_WITH_A_USER_NAME"
//#define OTA_PASSWORD  "REPLACE_WITH_A_PASSWORD"
*/
// ************************************************************************
// End of Secrets.h
// ************************************************************************

#ifndef OTA_USER
#define OTA_USER "admin"
#endif
#ifndef OTA_PASSWORD
#define OTA_PASSWORD "submit"
#endif

const uint32_t connectPeriod = 90;              // Max period (in s) for setting up a wifi connection
const uint32_t rebootIntoWifiPeriod = 20000;    // If rebooted within this period (in ms) after startup, the system will start in OTA update mode
const uint32_t otaModePeriod = 600000;          // Max period (in ms) to stay in OTA update mode without an update, then reboot into weather station mode

uint16_t numBoots = 0;
uint8_t startWifi = 0;              // Checked at startup; 0 is regular boot, 8 is a boot into wifi
bool webServerRunning = false;
bool updateAuthorized = false;      // True if the firmware upload in progress was sent by an authenticated user
bool testMode = false;              // Set to true to run only unit tests
String indexPage;                   // The OTA update page, with the number of boots filled in

// SHT31 state. When a reading fails, the last valid values are transmitted.
bool shtFound = false;              // True if the SHT31 responded to begin()
uint16_t shtFailures = 0;           // Number of failed readings in a row
const uint16_t SHT_FAILURES_BEFORE_RESTART = 3;  // Restart the sensor after this many failed readings in a row

// Timer interrupt declarations
volatile uint32_t timerInterruptCounter = 0;
volatile uint32_t currentIsrAt = 0;
volatile uint32_t previousTransmitAt = 0;

hw_timer_t* timer = NULL;
portMUX_TYPE timerMux = portMUX_INITIALIZER_UNLOCKED;
const uint32_t LOOP_PERIOD = 48000;
volatile SemaphoreHandle_t timerSemaphore;

// Handle timer interrupts (every 0.25s)
void IRAM_ATTR onTimer() {
  portENTER_CRITICAL_ISR(&timerMux);
  timerInterruptCounter = timerInterruptCounter + 1;
  currentIsrAt = millis();
  portEXIT_CRITICAL_ISR(&timerMux);

  // Release the semaphore that we check for in the loop
  xSemaphoreGiveFromISR(timerSemaphore, NULL);
}

const int DIRECTION_DIVIDER = 4;    // Every x loops do we sample the direction
int windDirDivider = DIRECTION_DIVIDER;

bool timeSetByDcf = false;          // True if the time has been set by the DCF receiver
bool timeTransmitted = false;       // True if the time has been sent to the base station at least once

void HandleSerialPort(char c) {
  static unsigned long value;

  if ('0' <= c && c <= '9') {
    value = 10 * value + c - '0';
  }
  else if ('a' <= c && c <= 'z') {
    switch (c) {
    case 'i':
      wh1080.initializeRfm();
      break;
    case 'p':
      wh1080.printAllRfmRegs();
      break;
    case 'r':
      wh1080.resetRfm();
      break;
    case 's':
      wh1080.sensorDataUnitTest();
      break;
    case 't':
      wh1080.timeDataUnitTest();
      break;
    case 'q':
      Serial.println("Rebooting");
      delay(3000);
      ESP.restart();
      break;
    }
    value = 0;
  }
}

//#######################################################################################
// OTA Update Page
// The page is protected by HTTP Basic authentication (OTA_USER / OTA_PASSWORD), which the
// web server checks, so the upload cannot be done without logging in.
// {BOOTS} is replaced by the number of boots.

const char* indexPageTemplate =
"<center><font size=4><b>Weather Station</b>"
"<br>Number of boots: {BOOTS}</font></center><br>"
"<script src='https://ajax.googleapis.com/ajax/libs/jquery/3.2.1/jquery.min.js'></script>"
"<form method='POST' action='#' enctype='multipart/form-data' id='upload_form'>"
   "<input type='file' name='update'>"
        "<input type='submit' value='Update'>"
    "</form>"
 "<div id='prg'>progress: 0%</div>"
 "<script>"
  "$('form').submit(function(e){"
  "e.preventDefault();"
  "var form = $('#upload_form')[0];"
  "var data = new FormData(form);"
  " $.ajax({"
  "url: '/update',"
  "type: 'POST',"
  "data: data,"
  "contentType: false,"
  "processData:false,"
  "xhr: function() {"
  "var xhr = new window.XMLHttpRequest();"
  "xhr.upload.addEventListener('progress', function(evt) {"
  "if (evt.lengthComputable) {"
  "var per = evt.loaded / evt.total;"
  "$('#prg').html('progress: ' + Math.round(per*100) + '%');"
  "}"
  "}, false);"
  "return xhr;"
  "},"
  "success:function(d, s) {"
  "$('#prg').html('Update: ' + d + ', rebooting');"
 "},"
 "error: function (a, b, c) {"
  "$('#prg').html('Update failed: ' + c);"
 "}"
 "});"
 "});"
 "</script>";

//#######################################################################################
// Helper functions

// Reboot into weather station mode after OTA update mode.
void restartWithoutWifi() {
  // Disconnect WiFi. Apparently, this is necessary in order to use ADC2 GPIO after the reboot.
  WiFi.disconnect();
  delay(100);
  WiFi.mode(WIFI_OFF);
  delay(500);
  ESP.restart();
}

// Read temperature and humidity from the SHT31 into weatherData. If the reading fails,
// weatherData keeps the last valid values and the sensor is restarted after a few failures.
void readSht31() {
  float temperature, humidity;

  if (shtFound && sht.readBoth(&temperature, &humidity) && !isnan(temperature) && !isnan(humidity)) {
    weatherData.temperature = temperature;
    weatherData.humidity = humidity;
    shtFailures = 0;
    return;
  }

  shtFailures++;
  Serial.print(F("SHT31 reading failed ("));
  Serial.print(shtFailures);
  Serial.println(F(" in a row), sending the last valid values"));

  if (!shtFound || shtFailures % SHT_FAILURES_BEFORE_RESTART == 0) {
    Serial.println(F("Restarting SHT31 sensor"));
    shtFound = sht.begin(0x44);
  }
}

//#######################################################################################
// Setup and Loop

void setup() {
  Serial.begin(115200);

  // Initialize EEPROM with predefined size
  preferences.begin(host);
  
  // Read from flash memory
  numBoots = preferences.getUShort("numBoots", 0);
  startWifi = preferences.getUChar("startWifi", 0);
  Serial.print("Boot #");
  Serial.println(++numBoots);
  preferences.putUShort("numBoots", numBoots);

  // Create semaphore to inform us when the timer has fired
  timerSemaphore = xSemaphoreCreateBinary();

  // If the right value was set in EEPROM, start WiFi and wait for the software to be updated.
  // Otherwise, start in weather station mode. This solution was chosen because several GPIOs
  // are used that conflict with the use of WiFi.
  // Please note that two power cycles are needed to get ADC2 working correctly again after WiFi was used.
  if (startWifi != 0) {
    // Make sure WiFi will not be started again at the next boot.
    preferences.putUChar("startWifi", 0);

    //  This is here to force the ESP32 to reset WiFi and initialize correctly.
    Serial.println("Starting in OTA update mode");
    Serial.print("WiFi status = ");
    Serial.println(WiFi.getMode());
    WiFi.disconnect(true);
    delay(1000);
    WiFi.mode(WIFI_STA);
    delay(1000);
    Serial.print("WiFi status = ");
    Serial.println(WiFi.getMode());
    // End initialization
      
    // Connect to Wi-Fi network with SSID and password
    Serial.print("Connecting to ");
    Serial.println(ssid);
  
    // Initialize wifi
    WiFi.begin(ssid, password);
  
    // Try to connect for some time and then leave it.
    // Because most of the inputs I use are on ADC2, they cannot be used at the same time
    // as WiFi. Therefore I will have to make sure the weather station only connects
    // to my router when I want to update the software.
    time_t firstCheckAt = now();
    while ((WiFi.status() != WL_CONNECTED) && (now() < firstCheckAt + connectPeriod)) {
      delay(500);
      Serial.print(".");
    }
  
    if (WiFi.status() == WL_CONNECTED) {
      Serial.println("Connected");
      Serial.print("IP address: ");
      Serial.println(WiFi.localIP());
      // Use mDNS for host name resolution
  //    if (!MDNS.begin(host)) { //http://esp32.local
  //      Serial.println("Error setting up MDNS responder!");
  //      while (1) {
  //        delay(1000);
  //      }
  //    }
  //    Serial.println("mDNS responder started");

      // Put the number of boots in the index page
      indexPage = indexPageTemplate;
      indexPage.replace("{BOOTS}", String(numBoots));

      // Return the index page on GET, after logging in
      server.on("/", HTTP_GET, []() {
        if (!server.authenticate(OTA_USER, OTA_PASSWORD)) {
          return server.requestAuthentication();
        }
        server.sendHeader("Connection", "close");
        server.send(200, "text/html", indexPage);
      });

      // Handle uploading firmware file on POST
      server.on("/update", HTTP_POST, []() {
        if (!updateAuthorized) {
          return server.requestAuthentication();
        }
        server.sendHeader("Connection", "close");
        server.send(200, "text/plain", (Update.hasError()) ? "FAIL" : "OK");
        restartWithoutWifi();
      }, []() {
        HTTPUpload& upload = server.upload();
        if (upload.status == UPLOAD_FILE_START) {
          // Check the login before writing anything to flash
          updateAuthorized = server.authenticate(OTA_USER, OTA_PASSWORD);
          if (!updateAuthorized) {
            Serial.println("Update refused: not logged in");
            return;
          }
          Serial.printf("Update: %s\n", upload.filename.c_str());
          if (!Update.begin(UPDATE_SIZE_UNKNOWN)) { //start with max available size
            Update.printError(Serial);
          }
        }
        else if (!updateAuthorized) {
          // Ignore the rest of an upload that was refused
        }
        else if (upload.status == UPLOAD_FILE_WRITE) {
          // Flashing firmware to ESP
          if (Update.write(upload.buf, upload.currentSize) != upload.currentSize) {
            Update.printError(Serial);
          }
        } 
        else if (upload.status == UPLOAD_FILE_END) {
          if (Update.end(true)) { // true to set the size to the current progress
            Serial.printf("Update successful: %u\nRebooting...\n", upload.totalSize);
          } 
          else {
            Update.printError(Serial);
          }
        }
        else if (upload.status == UPLOAD_FILE_ABORTED) {
          Serial.println("Update aborted");
          Update.abort();
        }
      });
      
      server.begin();
      webServerRunning = true;
    }
    else {
      WiFi.disconnect();
      Serial.println();
      Serial.println("No wifi connection established, rebooting");
      delay(5000);
      ESP.restart();
    }
  }
  else {
    Serial.println("Starting in weather station mode");

    // Check for the SHT31 sensor
    Serial.println(F("Starting SHT31 sensor"));
    shtFound = sht.begin(0x44);
    if (!shtFound) {
      Serial.println(F("Could not find a valid SHT31 sensor, please check wiring. Will retry."));
    }
  
    //Serial.println(F("BH1750 initialization"));
    //lightMeter.begin();
  
    // Start monitoring the anemometer
    if (!testMode) {
      thies.initialize();
    }
  
    // Start monitoring the rain gauge
    wh1080.initialize();

    // Keep the same station ID across reboots, so the base station keeps receiving our data.
    // On the very first boot, the random ID made up by wh1080.initialize() is stored.
    byte stationId = preferences.getUChar("stationId", 0);
    if (stationId == 0) {
      stationId = wh1080.deviceID;
      preferences.putUChar("stationId", stationId);
    }
    wh1080.deviceID = stationId;
    Serial.print("Station ID: ");
    Serial.println(stationId, HEX);

    Serial.println("Setting up timer interrupt for wind speed calculation");

#if defined(ESP_ARDUINO_VERSION_MAJOR) && ESP_ARDUINO_VERSION_MAJOR >= 3
    // ESP32 Arduino core 3.x: create a timer that counts at 1 MHz.
    timer = timerBegin(1000000);

    // Attach onTimer function to our timer.
    timerAttachInterrupt(timer, &onTimer);

    // Call onTimer every 0.25s (250000 counts), repeat forever.
    timerAlarm(timer, 250000, true, 0);
#else
    // ESP32 Arduino core 1.x/2.x
    // Use first timer of 4 (counted from zero).
    // Set divider to 40000 for prescaler. At 80 MHz clock speed this means that a trigger is
    // given 2000 times per second (see ESP32 Technical Reference Manual for more info).
    timer = timerBegin(0, 40000, true);

    // Attach onTimer function to our timer.
    timerAttachInterrupt(timer, &onTimer, true);

    // Set alarm to call onTimer function every 0.25s
    // Repeat the alarm (third parameter)
    timerAlarmWrite(timer, 500, true);

    // Start the first alarm
    timerAlarmEnable(timer);
#endif

    // Make sure WiFi will be started at the next boot, if it occurs within rebootIntoWifiPeriod ms.
    preferences.putUChar("startWifi", 8);

    // In test mode we just do a bunch of unit test and stop operations
    if (testMode) {
      delay(7000);
      wh1080.frequencyTest();
      wh1080.sensorDataUnitTest();
      wh1080.timeDataUnitTest();
      thies.unitTest();
      while (true);
    }
  }
  
  Serial.println("Initialization done");
  Serial.println();  
}

// The main loop of this sketch handles collecting weather and time data and sending it to the base station (WH1080).
void loop() {
  int windDirSample __attribute__((unused));    // Only used by the calibration test code below

  // When the system is running more than 20s, the user does not want to reboot into OTA mode.
  if (startWifi == 0 && millis() > rebootIntoWifiPeriod) {
    Serial.println("Next boot will be in weather station mode");
    preferences.putUChar("startWifi", 0);
    startWifi = 8;
  }
  
  // Handle the commands from the serial port
  if (Serial.available()) {
    HandleSerialPort(Serial.read());
  }

  if (webServerRunning) {
    // Handle the webserver for OTA
    server.handleClient();

    // Don't stay in OTA update mode forever, e.g. after two quick power cycles.
    if (millis() > otaModePeriod && !Update.isRunning()) {
      Serial.println("No update received, rebooting into weather station mode");
      restartWithoutWifi();
    }
  }
  else {
    // Check the rain bucket for rain
    wh1080.sampleRainGauge();
  }
  
  // If the Timer has fired, start managing the data. When the timer fires is controlled by onTimer().
  // This won't get executed when the webserver is running.
  if (xSemaphoreTake(timerSemaphore, 0) == pdTRUE) {
    uint32_t isrCount = 0, isrTime = 0;

    // Read the interrupt count and time
    portENTER_CRITICAL(&timerMux);
    isrCount = timerInterruptCounter;
    isrTime = currentIsrAt;
    portEXIT_CRITICAL(&timerMux);

    // Every 0.25s we calculate the wind speed and gust
    thies.sampleWindSpeed();

    // The wind direction should be sampled every second
    if (windDirDivider == 1) {
      windDirSample = thies.sampleWindDirection();
      windDirDivider = DIRECTION_DIVIDER;

      // Check the RFM chip too. I had the problem that the settings got lost once in a while.
      if (!wh1080.rfmIsValid()) {
        wh1080.resetRfm();
        wh1080.initializeRfm();
      }
    }
    else {
      windDirDivider--;
    }

    // Check if we need to calculate and transmit weather data (once every 48s).
    // Written as a subtraction, so it keeps working when millis() rolls over after 49.7 days.
    if (isrTime - previousTransmitAt >= LOOP_PERIOD) {
      previousTransmitAt += LOOP_PERIOD;

      // Print timer interrupt count and time
      Serial.println("-------------------------------------------");
      Serial.print("Call to onTimer no. ");
      Serial.print(isrCount);
      Serial.print(" occurred at ");
      Serial.print(isrTime);
      Serial.println(" ms");

      // Temperature and humidity
      readSht31();
      Serial.print(F("Temperature = "));
      Serial.print(weatherData.temperature);
      Serial.println(" *C");

      Serial.print(F("Humidity = "));
      Serial.print(weatherData.humidity);
      Serial.println(" %");

      // One tip of the bucket equals ~0.3 mm of rain. (Or is it 0.2794? To be calibrated.)
      weatherData.rain = wh1080.readRain();
      Serial.print(F("Rain = "));
      Serial.print(0.3f * weatherData.rain);
      Serial.println(" mm");

      //Wire.begin(0x23);

      // Light level
      //      frame.lux = lightMeter.readLightLevel();
      //      Serial.print("Light: ");
      //      Serial.print(lux);
      //      Serial.println(" lx");
      //      Serial.println();

      // Wind speed
      weatherData.windSpeed = thies.getWindSpeed();
      Serial.print("Wind speed: ");
      Serial.print(weatherData.windSpeed);
      Serial.println(" m/s");

      weatherData.windGust = thies.getWindGust();
      Serial.print("Gust: ");
      Serial.print(weatherData.windGust);
      Serial.println(" m/s");

      // Wind direction
      weatherData.windDir = thies.getWindDirection();
      Serial.print("Direction: ");
      Serial.println(weatherData.windDir);

      // Test code: To calibrate wind direction through the base station,
      // show the direction in the field for wind speed.
      //weatherData.windSpeed = ((float)windDirSample) / 100;

      /*
         On the WH1080, the DCF code is transmitted five times with 48 second intervals
         between 3-6 minutes past a new hour. The sensor data transmission stops in the
         59th minute. Then there are no transmissions for three minutes, apparently to
         be noise free to acquire the DCF77 signal.
         For my system I have decided to send the DCF code only once or twice an hour to
         improve accuracy of the weather data. The reliability does not seem to suffer.
      */

      if (timeSetByDcf) {
        if (minute() == 3 || !timeTransmitted) {
          // Transmit the current time to the base station
          wh1080.transmitTimeData();

          timeTransmitted = true;
        }
        else {
          if (minute() < 3) {
            // Update the internal clock if a new time was received over DCF
            Serial.print("Checking for new time at minute ");
            Serial.println(minute());
            wh1080.updateTime();
          }
          else if (minute() == 4) {
            // Turn off the DCF receiver
            wh1080.disableDcfReceiver();
          }
          else if (minute() == 59) {
            // Turn on the DCF receiver
            wh1080.enableDcfReceiver();
          }

          // Pass all weather data to the WH1080 instance
          wh1080.setSensorData(&weatherData);
  
          // Send the weather data to the base station
          wh1080.transmitSensorData();

          // Reset the gust after each transmit
          thies.resetWindGust();
        }
      }
      else {
        // Pass all weather data to the WH1080 instance
        wh1080.setSensorData(&weatherData);
  
        // Send the weather data to the base station
        wh1080.transmitSensorData();

        // Reset the gust after each transmit
        thies.resetWindGust();

        Serial.println("Reading DCF time");
        timeSetByDcf = wh1080.updateTime();
      }

      // Once a day reset the running sums, so a bad value doesn't propagate over time.
      if (hour() == 23 && minute() == 59 && second() > 11) {
        //wh1080.resetRain();  We don't need to do this, rain is total since startup
        thies.resetVars();
      }
    }
  }
  else {
    delay(1);
  }
}
