Tsjakka/WeatherStation/(commit log)

2020-01-03 Add schematic
2020-02-18 Fix for negative temperatures. Smaller wind speed buffer to prevent averaging by both ESP and base station.
    [Thies.cpp, Thies.h, WH1080.cpp]
2020-05-01 Wind direction buffer shortened to 48s. Fixes to direction and temperature calculation. Shows number of boots on OTA html page.
    [Thies.cpp, Thies.h, WH1080.cpp, WH1080.h, WeatherStation.ino]
2021-05-02 Replaced BME280 by SHT31, because of lackluster reliability. Cleaned up #include's. Changed wind speed pin from 12 to 14.
    [Thies.cpp, WeatherStation.ino]
2026-11-05 Fixes from a code review. Source folder renamed to WeatherStation, so the Arduino IDE opens the sketch directly.
    WiFi credentials moved to Secrets.h, which is included by the sketch and excluded from git.
    Transmit timing keeps working when millis() rolls over after 49.7 days.
    SHT31: temperature and humidity are read in one measurement; a failed reading keeps the last valid values and the sensor is restarted after 3 failures in a row.
    OTA mode: reboots into weather station mode after 10 minutes without an update; the page and the upload are protected by HTTP Basic authentication (OTA_USER / OTA_PASSWORD, default admin / submit).
    Wind direction: the average is rounded instead of truncated, and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
2026-11-05 KiCad project for the sensor unit in the new Kradex Z74JH enclosure (Hardware folder).
    Schematic drawn from Photos/Schematic.jpg, with the wiring as built: wind speed on GPIO14 with a 10k pull-down, wind direction moved to GPIO34 (ADC1) with 570 Ohm from 5 V and a 3.3 V Zener diode as protection, DCF1 header in the order PON, OUT, GND, VDD, and the 868 MHz antenna soldered directly onto the RFM69HW.
    PCB of 114 x 66 mm, 2 layers, fully routed with ground fills on both layers. Mounting holes on the bosses of the enclosure bottom (107.6 x 52.7 mm) and on the two inner bosses under the board. ESP32 DevKit, RFM69HW and DCF1 on sockets, pluggable 5.08 mm terminal blocks for the anemometer, rain ga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
2026-11-06 PCB moved to the upper half of the enclosure, so the cables can run through the free lower half to the bottom. RFM69 footprint corrected.
    Board of 114 x 64 mm on the bosses at y 20.65 and 73.35 mm (107.6 x 52.7 mm apart) and the two inner bosses, below the lid bosses in the top corners and above the bulges halfway down the side walls.
    RFM69HW footprint matches the module as it sits in the socket, labelled side up: 3.3V to RESET in the left row, GND, ANA, GND, SCK, MISO, MOSI, NSS, NC in the right row, rows 17.5 mm apart. The antenna pin is on the right, away from the ESP32.
    RFM69 moved about 8 mm to the right, the DCF1 about 2 mm to the right and down, with VDD (antenna wires) at the bottom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
2026-11-06 Manufacturing files for the PCB (Hardware/Production/WeatherStation-gerbers.zip).
    Gerbers for both copper layers, both solder masks and silkscreens and the board outline, plus Excellon drill files in mm with plated (84) and unplated (6 mounting) holes in separate files. Exported after a DRC with refilled zones: no violations. 2 layers, 1.6 mm, 114 x 64 mm; smallest track 0.4 mm, clearance 0.2 mm, hole 0.4 mm.
